hughmancoder/fpga-spectrogram-visualiser/docs/images/butterfly-algorithm.jpeg

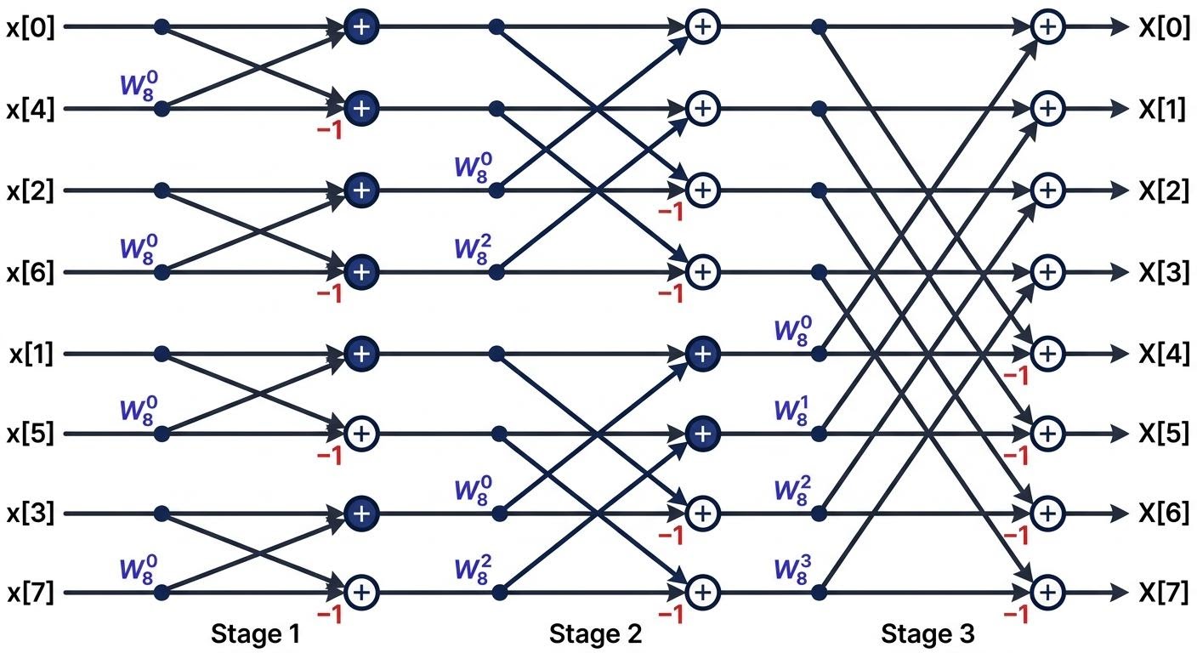
docs/images/butterfly-algorithm.jpeg
