hughmancoder/fpga-spectrogram-visualiser/docs/images/display_driver_8.JPG

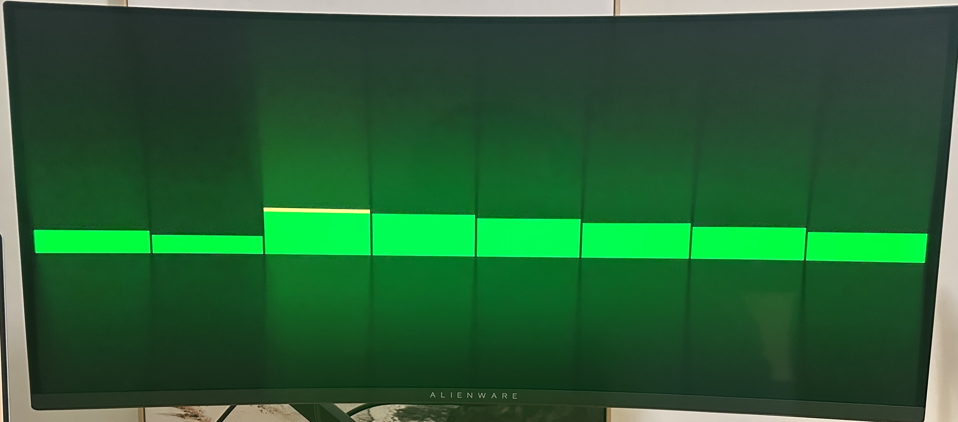
docs/images/display_driver_8.JPG
