hughmancoder/fpga-spectrogram-visualiser/docs/images/INMP441-Pinout.png

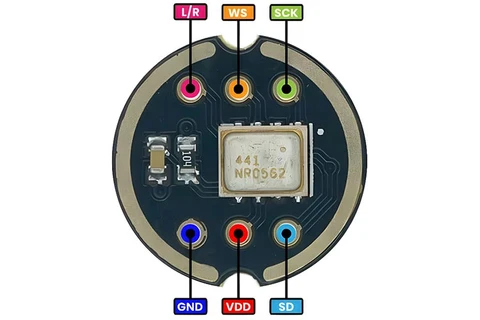
docs/images/INMP441-Pinout.png
