hughmancoder/fpga-spectrogram-visualiser/(commit log)

2026-11-02 Finish wiring up top module and implement spectrum_pattern_gen to test display driviing
2026-11-03 Implement fft module partitioning, state machine, and sample buffer.
2026-11-04 Fix top level module clock domain issues, add two flip flop syncrhonisers to reset so each clock domain released rest on own edges, update documentation
    [hdmi_clock_gen.sv, reset_sync.sv, top.sv, top_tb.sv]
2026-11-05 Update README and add schematic images
